dagodfader/Rifle-Level/(commit log)

2026-05-11 Add v0.1.0 rifle level firmware
    Initial firmware version with roll/cant LEDs, saved calibration, BLE output, startup battery status, and low battery warning.
2026-05-13 Update README and changelog for v0.2.4
    Updated project documentation to reflect the current firmware structure, BLE packet format, app fields, and v0.2.4 firmware changes.
2026-05-13 Update iOS reticle with pitch movement
2026-05-14 Updated firmware to v0.2.5
    Updated firmware to v0.2.5.
    Changes:
    - Added 60-second BLE advertising timeout
    - BLE stops advertising if no phone connects within the timeout window
    - BLE advertising restarts for another 60 seconds after a phone disconnects
    - Increased battery update interval from 5 seconds to 30 seconds to reduce blocking pauses
    - Added SERIAL_DEBUG switch and disabled serial output by default
    - Increased debug serial print interval to 3 seconds when enabled
    - Kept BLE packet interval at 150 ms
    - Left stability calculation unchanged
    - Physical LED update interval remains 20 ms
    [Rifle_Level.ino]
2026-05-14 Update README and changelog for v0.2.5
    Updated project documentation to reflect the current firmware structure, BLE packet format, app fields, and v0.2.5 firmware changes.
2026-05-14 Update iOS app for calibration status and BLE packet changes
2026-05-14 Update firmware to v0.2.9
    Updated firmware to v0.2.9.
    - Split BLE output into shorter packets to prevent truncation
    - Removed version field from live BLE packets
    - Changed live BLE data to alternate between cant and pitch/cosine packets
    - Added slow status packets for offset, stability, battery, and calibration flags
    - Added cc and pc fields for saved cant and pitch calibration status
    - Reduced BLE send rate to help prevent physical LED slowdown when connected
    - Reset commands now delete saved calibration files instead of saving 0
    - Startup calibration status now checks saved calibration flag instead of offset value
    - Physical LED behavior remains unchanged
    - Set fast BLE live pack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
    [Rifle_Level.ino]
2026-05-14 Update README and changelog for v0.2.9
    Updated documentation for firmware v0.2.9.
    - Documented short BLE packet format
    - Added current fast and slow BLE packet timing
    - Added cc and pc calibration flag descriptions
    - Noted that firmware version is not currently sent over BLE
    - Updated app command documentation
    - Added v0.2.9 changelog entry
    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
